Sanderhuisman/Presence-Sensor/pcb/presence_sensor.kicad_pcb

## KiCad design pcb/presence_sensor.kicad_pcb (2022-01-24)

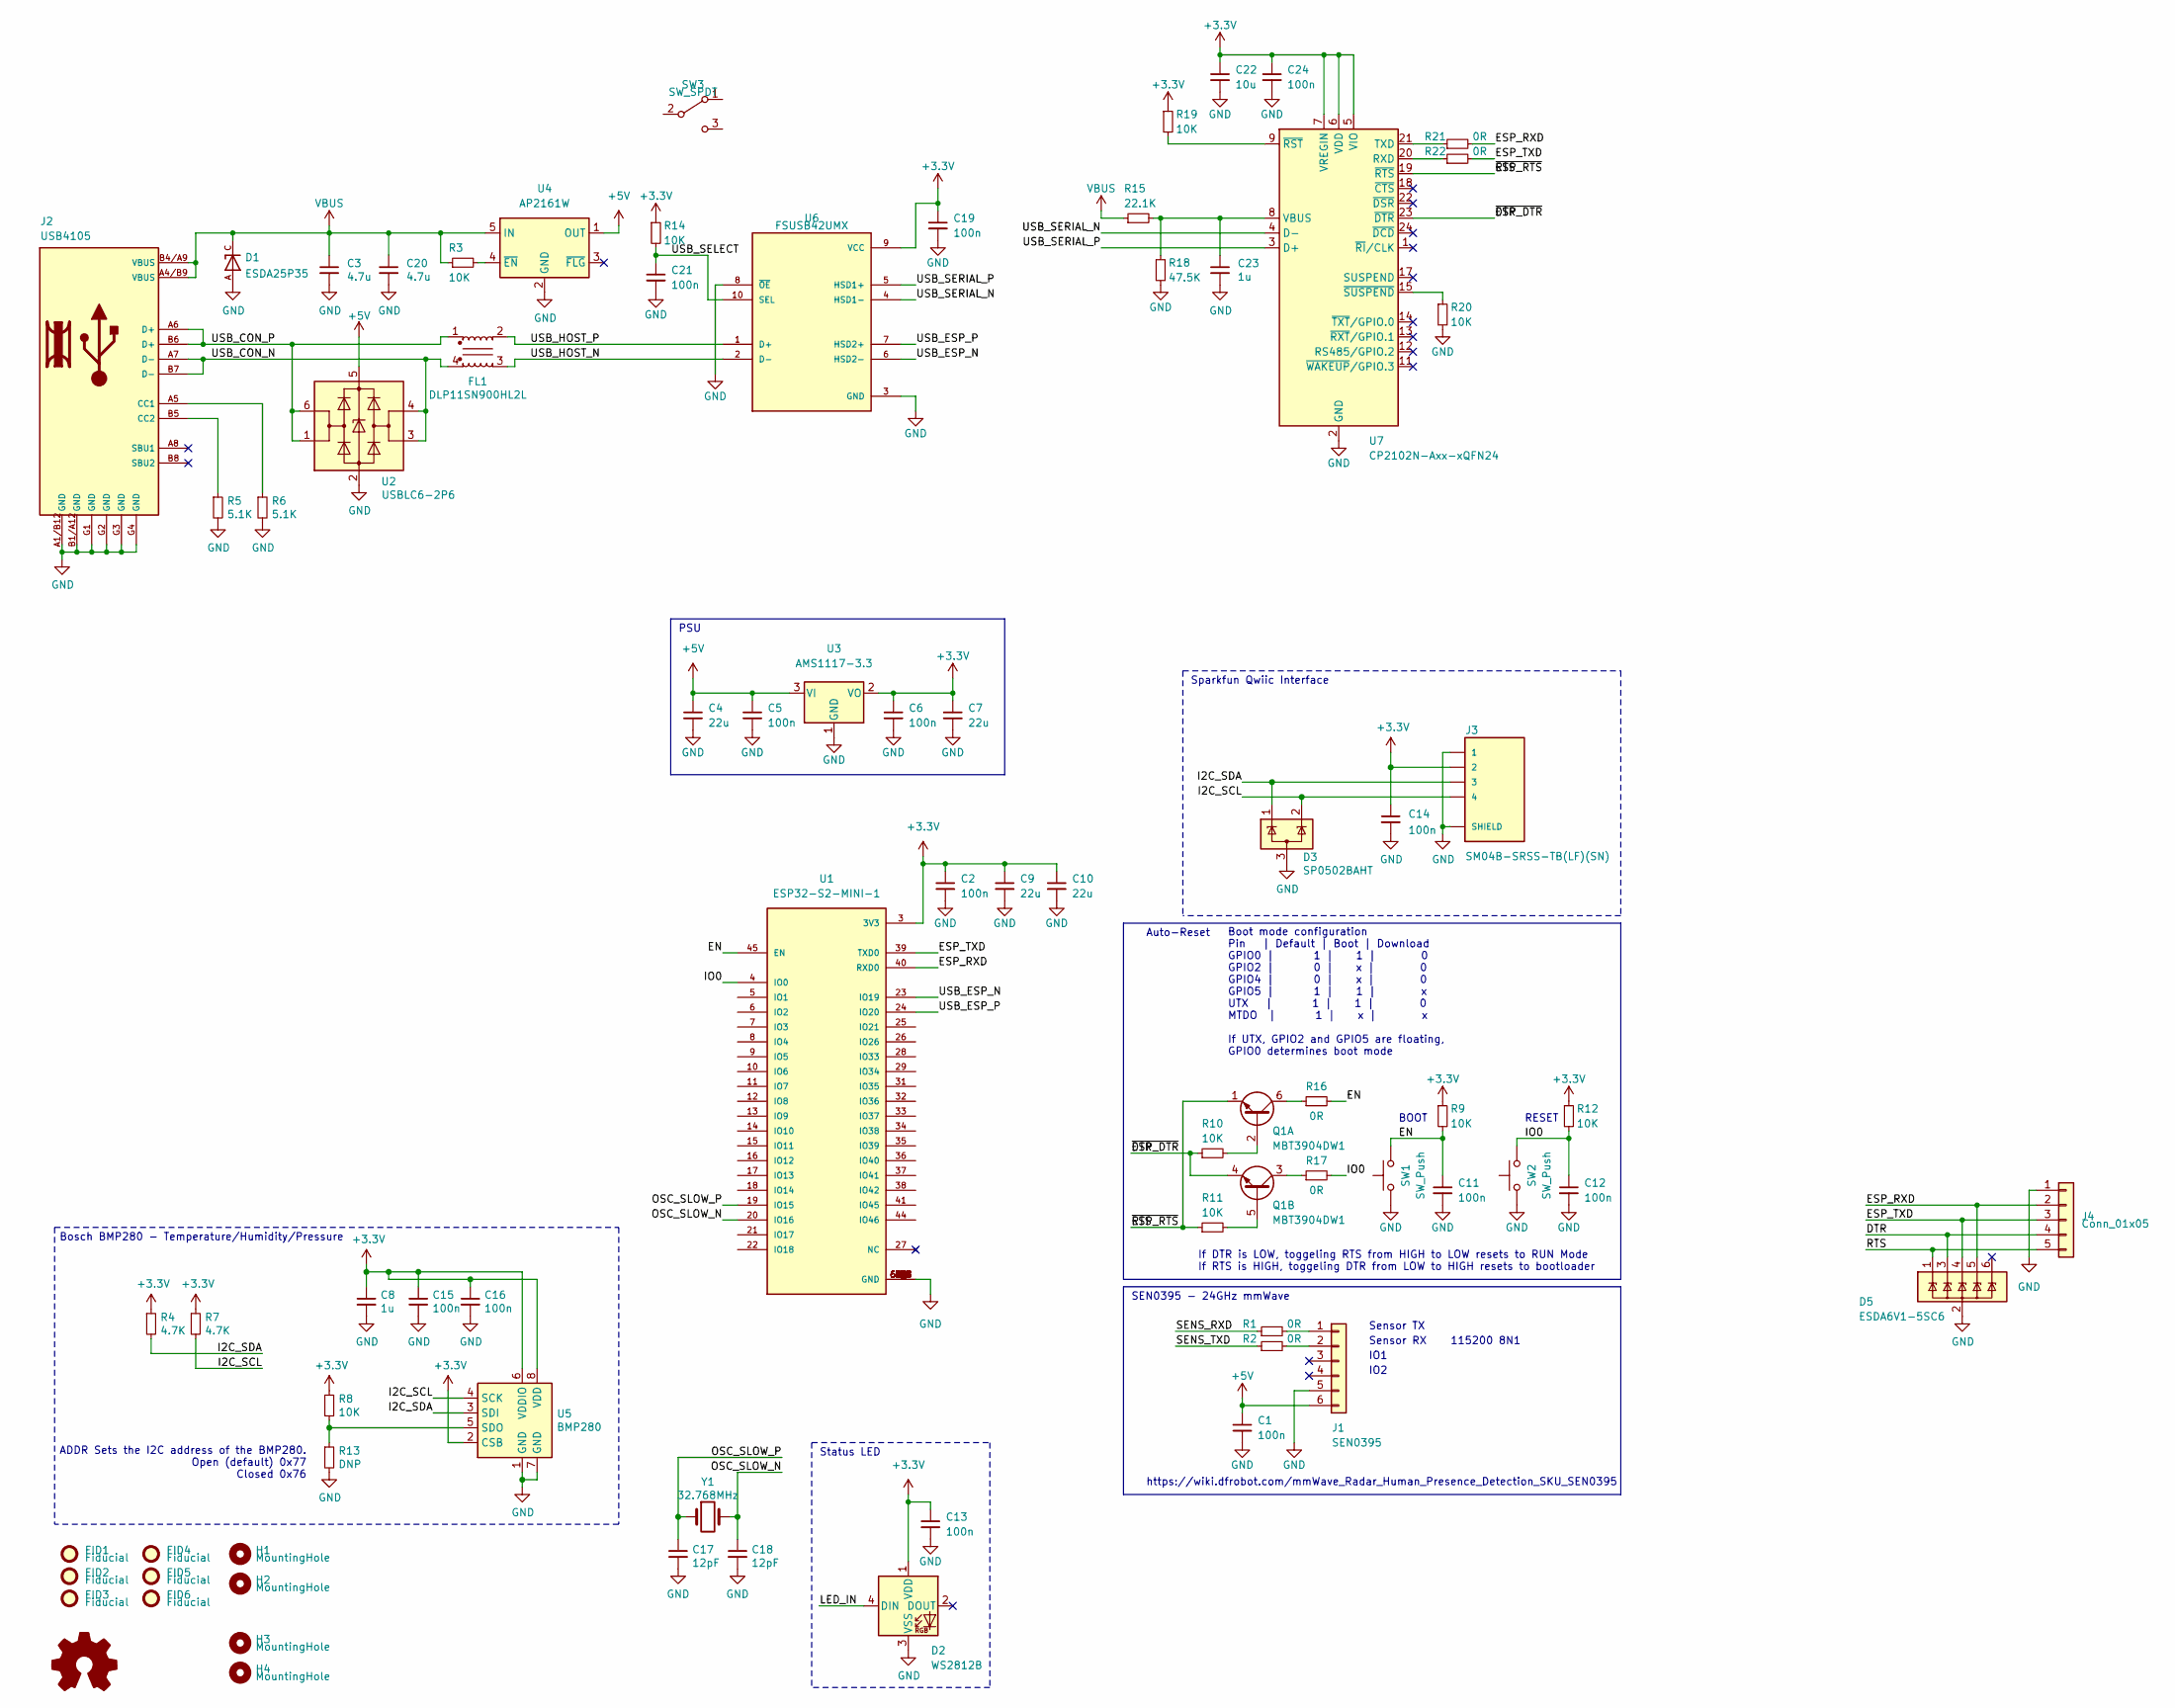
[picture p1: schematic presence_sensor.kicad_sch, ESP32 mmWave Sensor]

Parts:
C1, C2, C5, C6, C11, C12, C13, C14, C15, C16, C19, C21, C24: 100n; C_0603_1608Metric
C3, C20: 4.7u; C_0805_2012Metric
C4, C7, C9, C10: 22u; C_0805_2012Metric
C8, C23: 1u; C_0603_1608Metric
C17, C18: 12pF; C_0603_1608Metric
C22: 10u; C_0805_2012Metric
D1: ESDA25P35; TVS_ESDA25P35-1U1M
D2: WS2812B; LED_WS2812B_PLCC4_5.0x5.0mm_P3.2mm
D3: SP0502BAHT; SOT-23
D5: ESDA6V1-5SC6; SOT-23-6
FID1, FID2, FID3, FID4, FID5, FID6: Fiducial; Fiducial_0.5mm_Mask1mm
FL1: DLP11SN900HL2L; FIL_DLP11SN900HL2L; PARTREV N/A
H1, H2: MountingHole; MountingHole_2.7mm_M2.5
H3, H4: MountingHole; MountingHole_2.2mm_M2
J1: SEN0395; PinHeader_1x06_P2.54mm_Vertical
J2: USB4105; GCT_USB4105_REVA; PARTREV 0.2
J3: SM04B-SRSS-TB(LF)(SN); JST_SM04B-SRSS-TB(LF)(SN)
J4: Conn_01x05; PinHeader_1x05_P2.54mm_Vertical
Q1: MBT3904DW1; SOT-363_SC-70-6
R1, R2, R16, R17, R21, R22: 0R; R_0603_1608Metric
R3, R8, R9, R10, R11, R12, R14, R19, R20: 10K; R_0603_1608Metric
R4, R7: 4.7K; R_0603_1608Metric
R5, R6: 5.1K; R_0603_1608Metric
R13: DNP; R_0603_1608Metric
R15: 22.1K; R_0603_1608Metric
R18: 47.5K; R_0603_1608Metric
SW1, SW2: SW_Push; SW_Push_SPST_NO_Alps_SKRK
SW3: SW_SPDT; SW_Push_1P1T-SH_NO_CK_KMR2xxG
U1: ESP32-S2-MINI-1; XCVR_ESP32-S2-MINI-1
U2: USBLC6-2P6; SOT-666
U3: AMS1117-3.3; SOT-223-3_TabPin2
U4: AP2161W; SOT-23-5
U5: BMP280; Bosch_LGA-8_2x2.5mm_P0.65mm_ClockwisePinNumbering
U6: FSUSB42UMX; IC_FSUSB42UMX
U7: CP2102N-Axx-xQFN24; QFN-24-1EP_4x4mm_P0.5mm_EP2.6x2.6mm
Y1: 32.768MHz; NX3215SA; Part Number NX3215SA-32.768K-STD-MUA-8

Connections:
+3V3: C2.1, C6.1, C7.1, C8.1, C9.1, C10.1, C13.1, C14.1, C15.1, C16.1, C19.1, C22.1, C24.1, D2.1 (VDD), J3.2, R4.1, R7.1, R8.1, R9.1, R12.1, R14.1, R19.1, U1.3 (3V3), U3.2 (VO), U5.2 (CSB), U5.6 (VDDIO), U5.8 (VDD), U6.9 (VCC), U7.5 (VIO), U7.6 (VDD), U7.7 (VREGIN)
+5V: C1.1, C4.1, C5.1, J1.6, U2.5 (VBUS), U3.3 (VI), U4.1 (OUT)
/DTR: D5.3 (IO2), J4.4, Q1.4 (E2), R10.1, U7.23 (~DTR)
/EN: C11.1, R9.2, R16.2, SW1.2, U1.45 (EN)
/ESP_RXD: D5.5 (IO4), J4.2, R21.2, U1.40 (RXD0)
/ESP_TXD: D5.4 (IO3), J4.3, R22.2, U1.39 (TXD0)
/I2C_SCL: D3.2 (K), J3.4, R7.2, U5.4 (SCK)
/I2C_SDA: D3.1 (K), J3.3, R4.2, U5.3 (SDI)
/IO0: C12.1, R12.2, R17.2, SW2.2, U1.4 (IO0)
/LED_IN: D2.4 (DIN)
/OSC_SLOW_N: C18.1, U1.20 (IO16), Y1.2
/OSC_SLOW_P: C17.1, U1.19 (IO15), Y1.1
/RTS: D5.1 (IO1), J4.5, Q1.1 (E1), R11.1, U7.19 (~RTS)
/SENS_RXD: R1.1
/SENS_TXD: R2.1
/USB_CON_N: FL1.4, J2.A7 (D-), J2.B7 (D-), U2.3 (I/O2), U2.4 (I/O2)
/USB_CON_P: FL1.1, J2.A6 (D+), J2.B6 (D+), U2.1 (I/O1), U2.6 (I/O1)
/USB_ESP_N: U1.23 (IO19), U6.6 (HSD2-)
/USB_ESP_P: U1.24 (IO20), U6.7 (HSD2+)
/USB_HOST_N: FL1.3, U6.2 (D-)
/USB_HOST_P: FL1.2, U6.1 (D+)
/USB_SELECT: C21.1, R14.2, U6.10 (SEL)
/USB_SERIAL_N: U6.4 (HSD1-), U7.4 (D-)
/USB_SERIAL_P: U6.5 (HSD1+), U7.3 (D+)
GND: C1.2, C2.2, C3.2, C4.2, C5.2, C6.2, C7.2, C8.2, C9.2, C10.2, C11.2, C12.2, C13.2, C14.2, C15.2, C16.2, C17.2, C18.2, C19.2, C20.2, C21.2, C22.2, C23.2, C24.2, D1.A, D2.3 (VSS), D3.3 (A), D5.2 (GND), J1.5, J2.A1/B12 (GND), J2.B1/A12 (GND), J2.G1 (GND), J2.G2 (GND), J2.G3 (GND), J2.G4 (GND), J3.1, J3.S1 (SHIELD), J3.S2 (SHIELD), J4.1, R5.2, R6.2, R13.2, R18.2, R20.2, SW1.1, SW2.1, U1.1 (GND), U1.2 (GND), U1.30 (GND), U1.42 (GND), U1.43 (GND), U1.46 (GND), U1.47 (GND), U1.48 (GND), U1.49 (GND), U1.50 (GND), U1.51 (GND), U1.52 (GND), U1.53 (GND), U1.54 (GND), U1.55 (GND), U1.56 (GND), U1.57 (GND), U1.58 (GND), U1.59 (GND), U1.60 (GND), U1.61 (GND), U1.61_1 (GND), U1.61_2 (GND), U1.61_3 (GND), U1.61_4 (GND), U1.61_5 (GND), U1.61_6 (GND), U1.61_7 (GND), U1.61_8 (GND), U1.62 (GND), U1.63 (GND), U1.64 (GND), U1.65 (GND), U2.2 (GND), U3.1 (GND), U4.2 (GND), U5.1 (GND), U5.7 (GND), U6.3 (GND), U6.8 (~OE), U7.2 (GND), U7.25 (GND)
unnamed: J1.1, R1.2
unnamed: J1.2, R2.2
unnamed: J2.A5 (CC1), R6.1
unnamed: J2.B5 (CC2), R5.1
unnamed: Q1.2 (B1), R10.2
unnamed: Q1.6 (C1), R16.1
unnamed: Q1.5 (B2), R11.2
unnamed: Q1.3 (C2), R17.1
unnamed: R3.2, U4.4 (~EN)
unnamed: R8.2, R13.1, U5.5 (SDO)
unnamed: R22.1, U7.20 (RXD)
unnamed: R21.1, U7.21 (TXD)
unnamed: C23.1, R15.2, R18.1, U7.8 (VBUS)
unnamed: R19.2, U7.9 (~RST)
unnamed: R20.1, U7.15 (~SUSPEND)
VBUS: C3.1, C20.1, D1.C, J2.A4/B9 (VBUS), J2.B4/A9 (VBUS), R3.1, R15.1, U4.5 (IN)

Notes on the sheet:
Auto-Reset
Bosch BMP280 - Temperature/Humidity/Pressure
IO2
If DTR is LOW, toggeling RTS from HIGH to LOW resets to RUN Mode If RTS is HIGH, toggeling DTR from LOW to HIGH resets to bootloader
Status LED
IO1
https://wiki.dfrobot.com/mmWave_Radar_Human_Presence_Detection_SKU_SEN0395
RESET
SEN0395 - 24GHz mmWave
ADDR Sets the I2C address of the BMP280. Open (default) 0x77 Closed 0x76
Sensor RX
115200 8N1
Sensor TX
BOOT
PSU
Sparkfun Qwiic Interface
Boot mode configuration Pin | Default | Boot | Download GPIO0 | 1 | 1 | 0 GPIO2 | 0 | x | 0 GPIO4 | 0 | x | 0 GPIO5 | 1 | 1 | x UTX | 1 | 1 | 0 MTDO | 1 | x | x If UTX, GPIO2 and GPIO5 are floating, GPIO0 determines boot mode

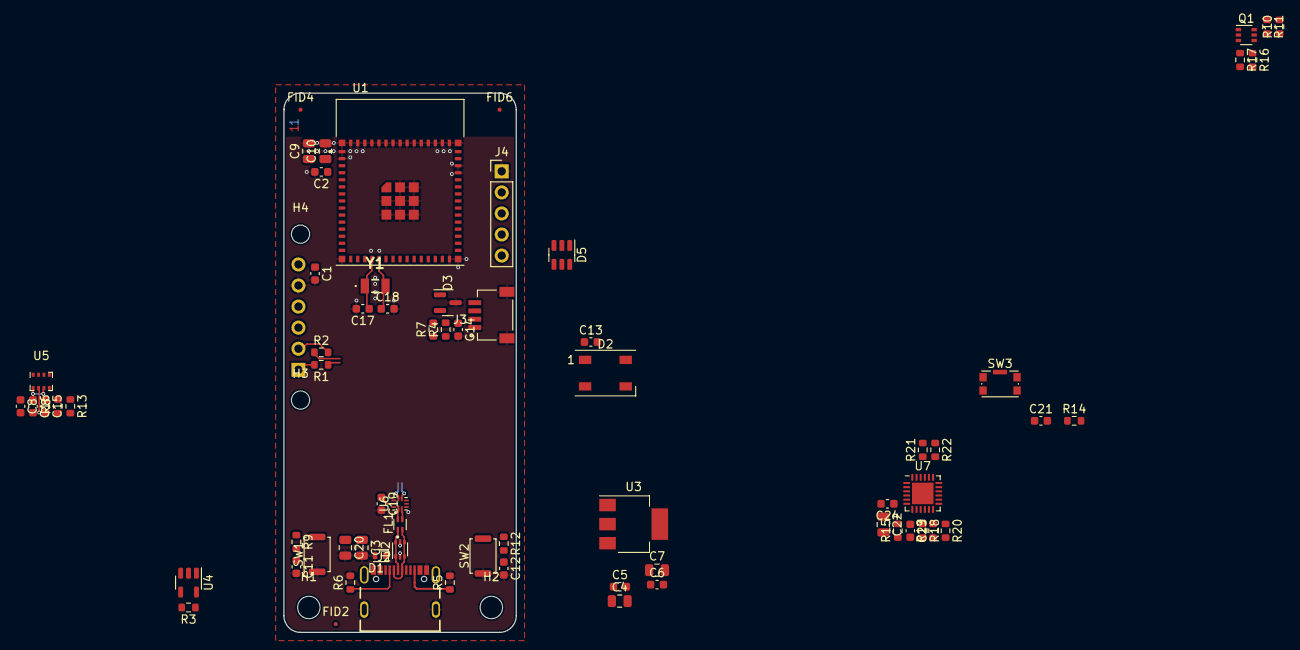
[picture p2: board presence_sensor.kicad_pcb from above]

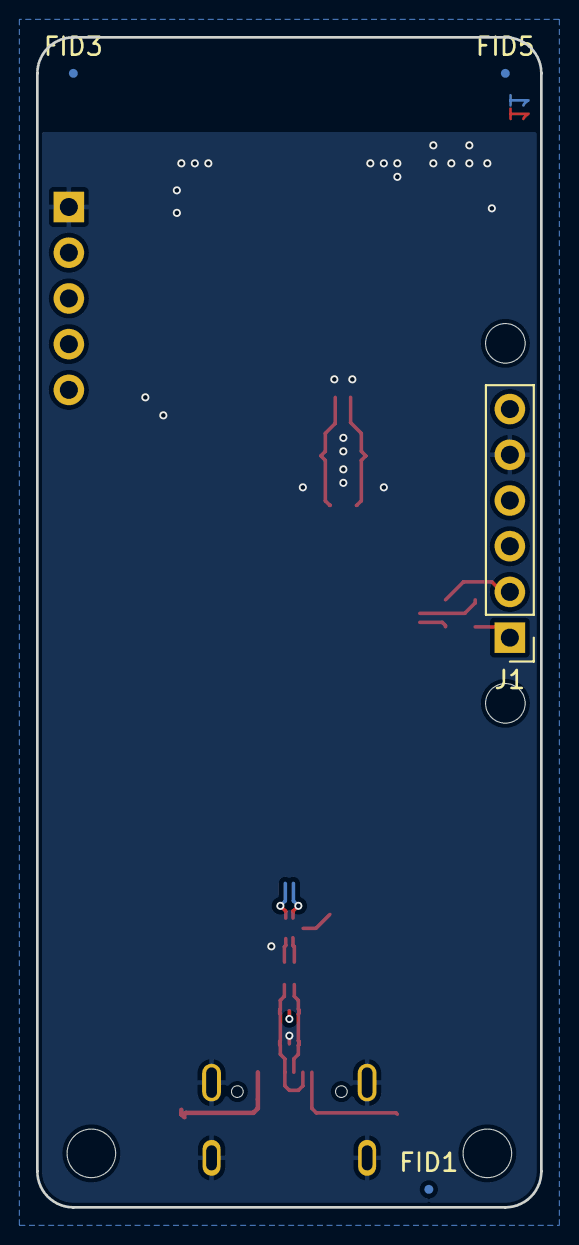
[picture p3: board presence_sensor.kicad_pcb from below]

Board: 2 copper layers, 28.0 x 65.0 mm, 77 parts (4 on the bottom side), 38 nets.
